johnbarbosas/IoT_Energy_Meter/Estrutura.jpeg

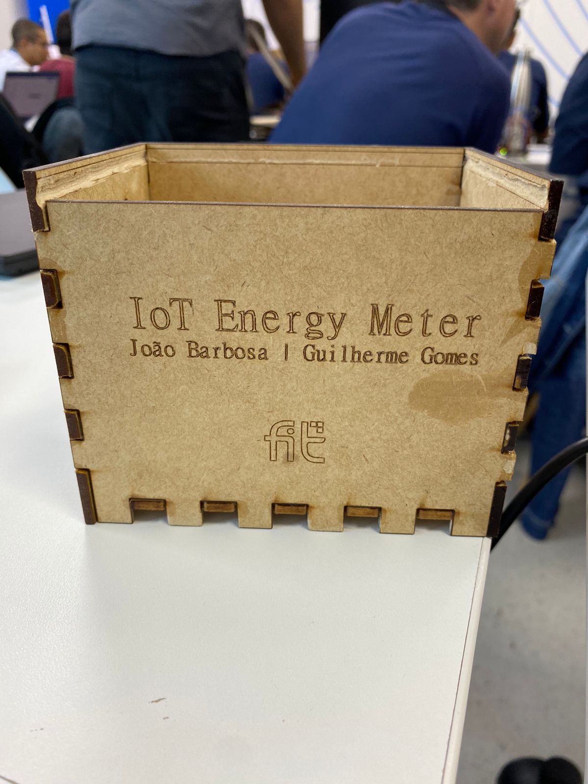
Estrutura.jpeg
